yc-kang/IOTSmartHome/README.md

# IOT Smart Home Project
 
## System Architecture
This is a ESP8266-based system, with smart home control capabilities  

Check out our [presentation](Presentation.pdf) and [report](Report.pdf)

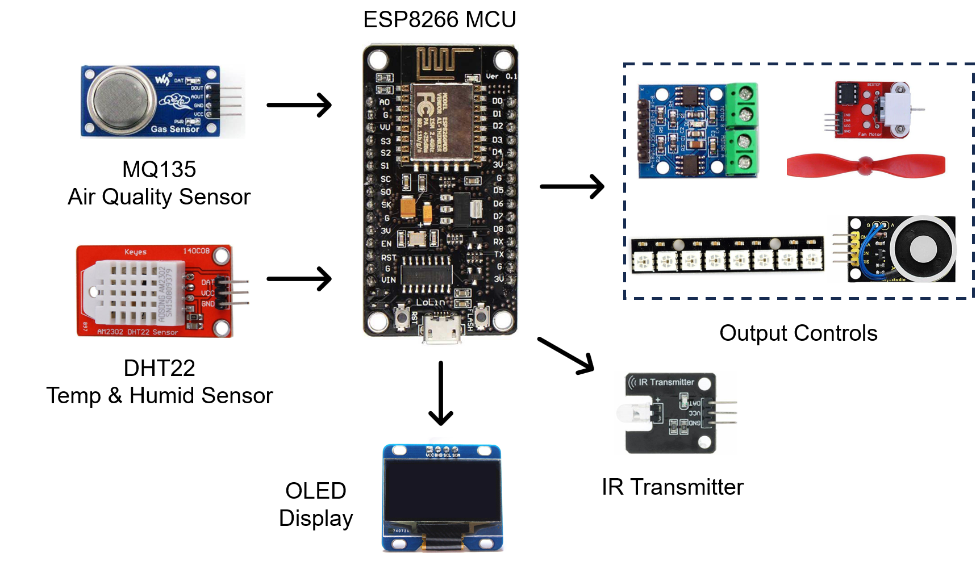
[picture p1: images/Diagram.png]

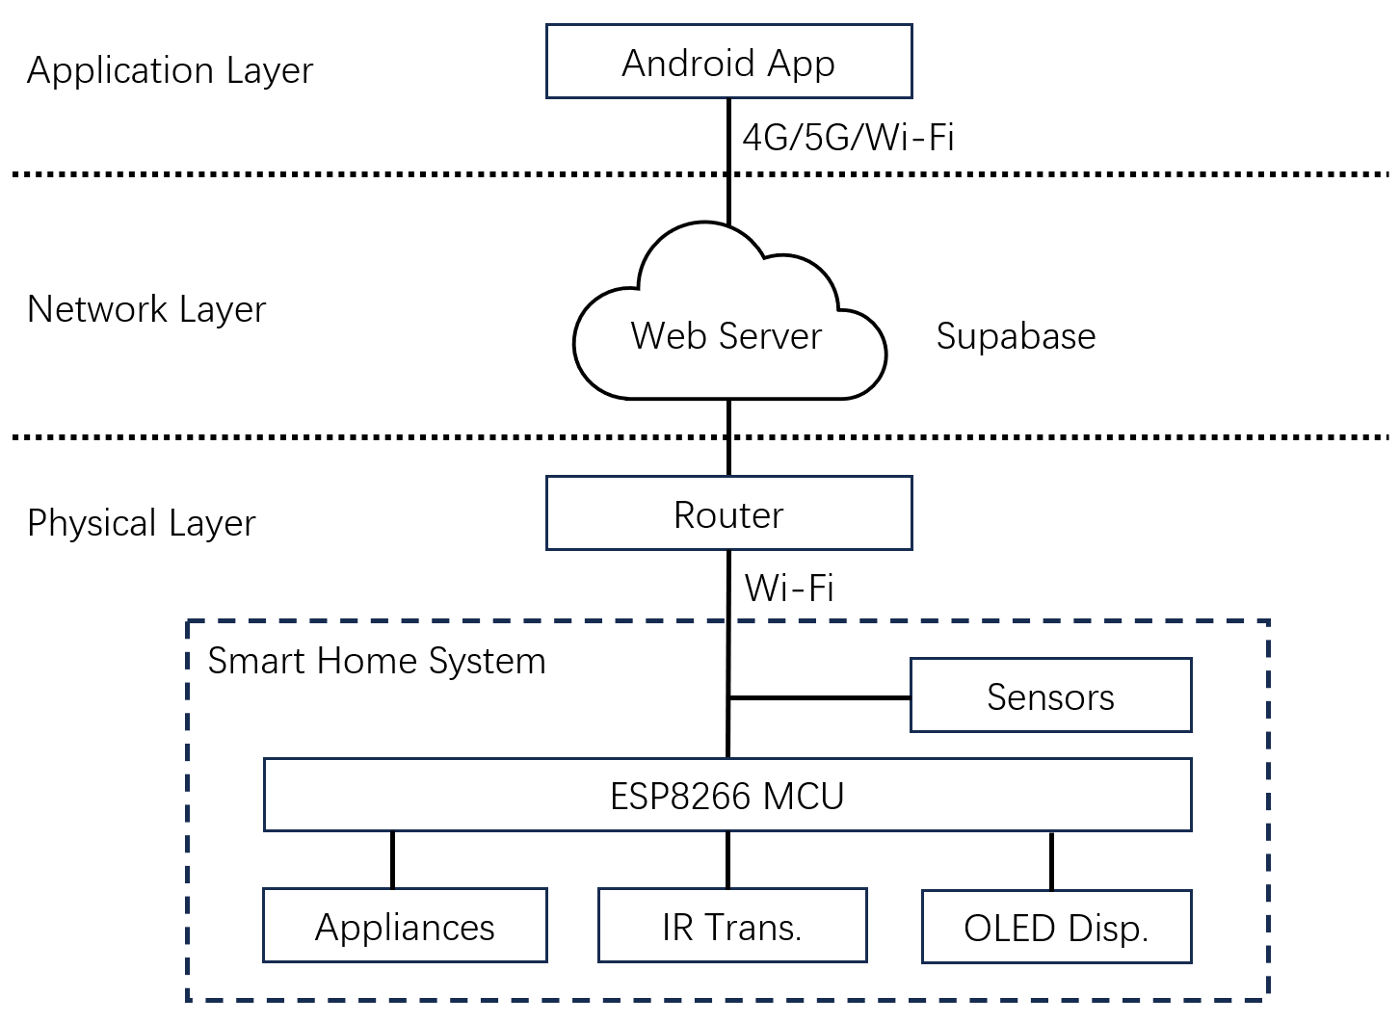
[picture p2: images/Diagram2.png]


## Circuits & PCB
Schematics, PCBs are designed via [EasyEDA](https://pro.easyeda.com/editor), referenced on [this](https://oshwhub.com/zijunchen/esp8266-extension_copy_copy_copy_copy_copy_copy_copy_copy)

The design can be access [here](Altium_NewProject_Schematic_PCB.zip), which can be imported into EasyEDA or Atrium Designer (AD)  
**Note**: Schematic, PCB, BOM List are included

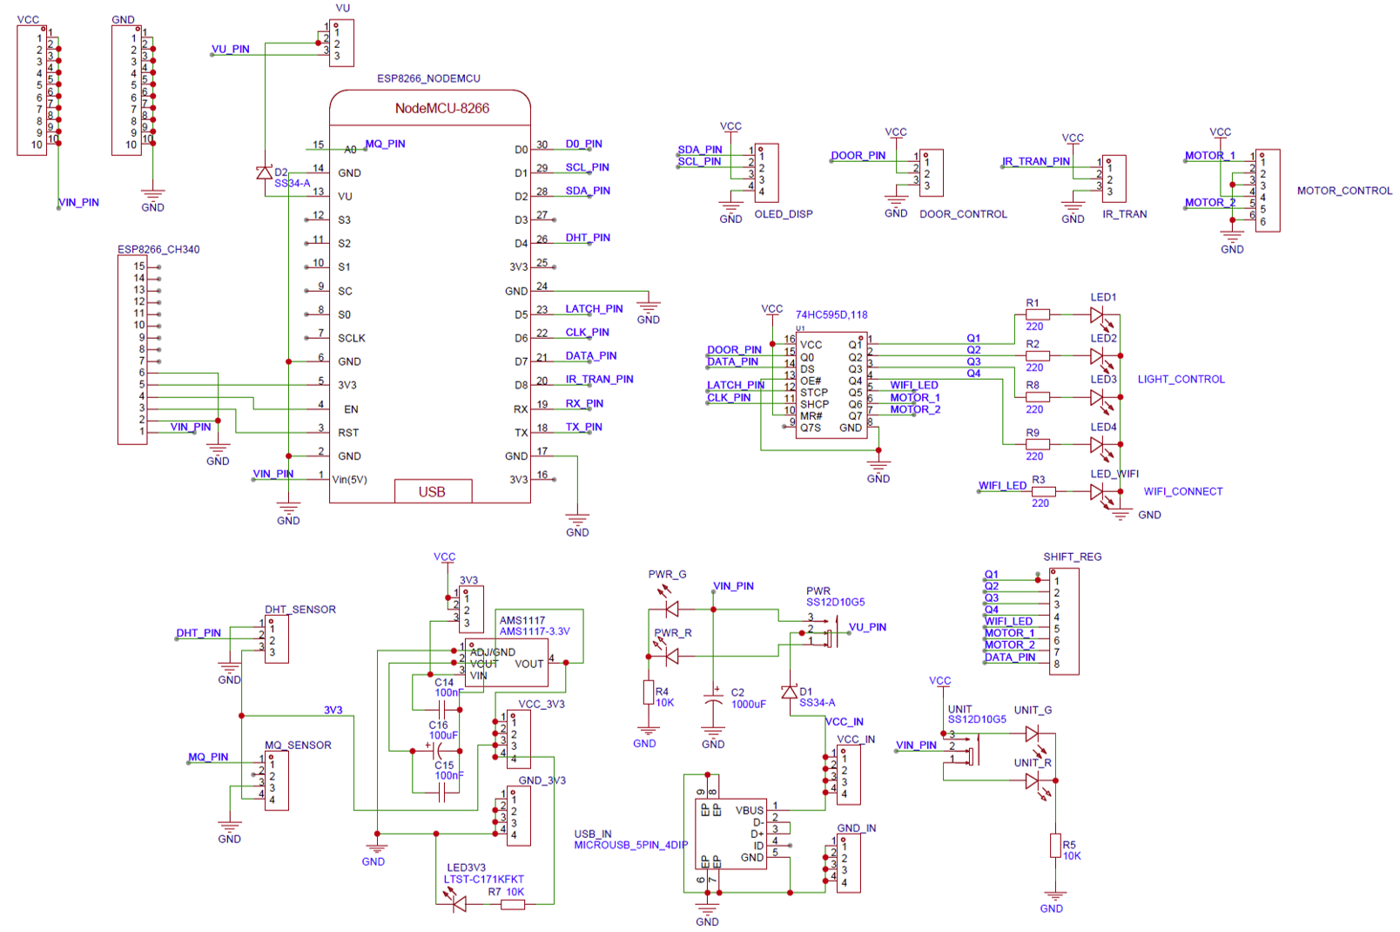
[picture p3: images/Schematic.png]


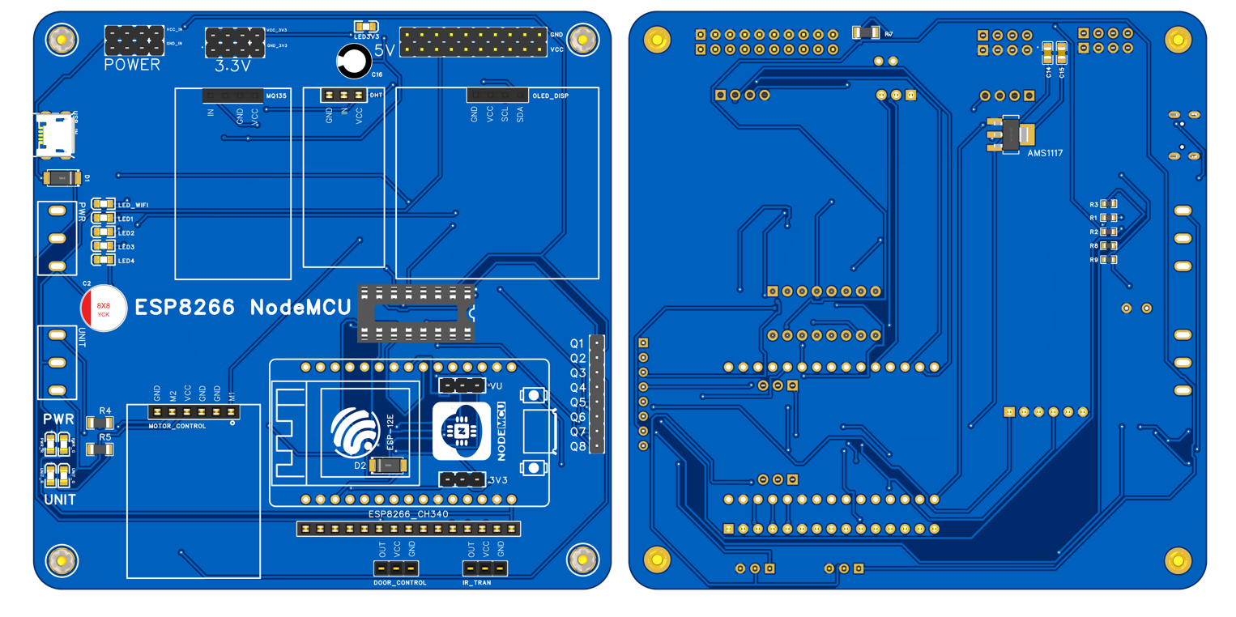
[picture p4: images/PCB.png]


Prototype
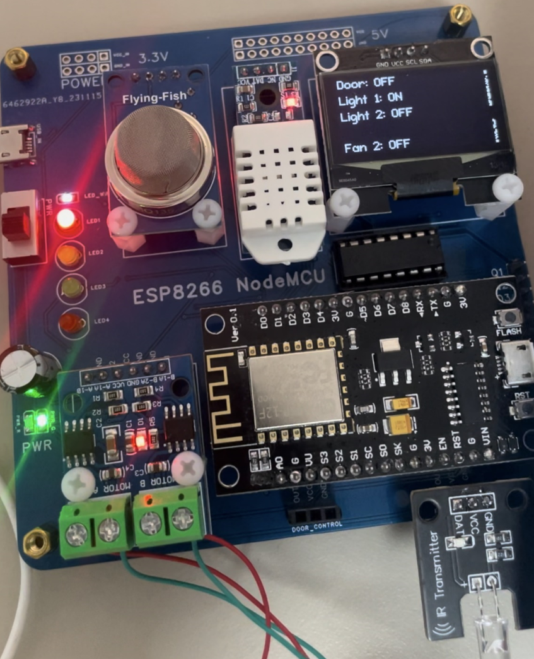
[picture p5: images/Prototype.png]


Demo
<div style="vertical-align:middle">Dataset
</div>

## Code Layout
The code is organized as follows:
- ESP8266/Main/ - Main code (ESP8266, in C)
- ESP8266/ManualTest/ - Testing (ESP8266, in C)
- AndroidApp - Flutter (in Dart)

## Android App
Designed via [FlutterFlow](https://www.flutterflow.io/), the app can be access [here](https://app.flutterflow.io/project/hotel-app-eamssf)  
*Currently in beta, not optimized for TabletView, WebApp yet
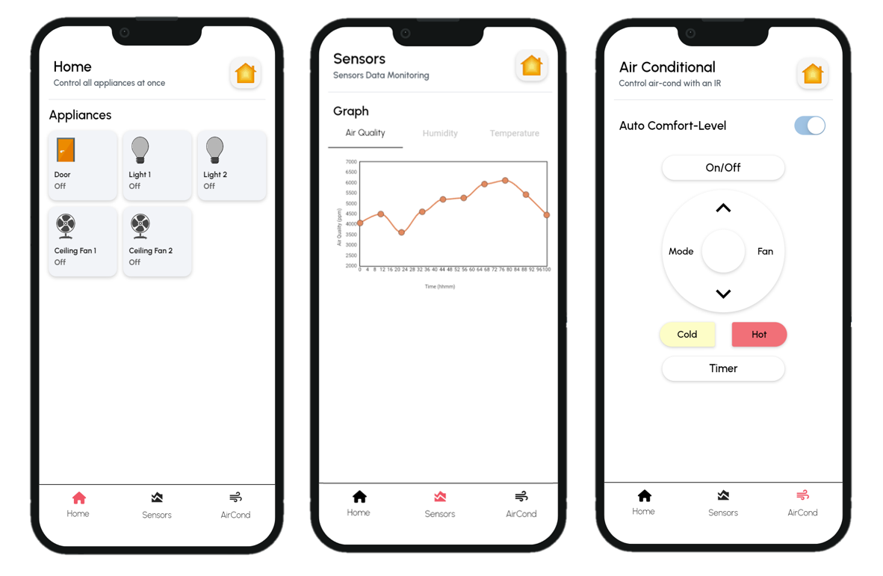
[picture p6: images/AppDesign.png]


It is **recommended** to edit in FlutterFlow directly, as oppose to import into Flutter  

## Database
Currently, the database is setup on Supabase, it's recommended to switch to Firebase, for better performance
