yc-kang/IOTSmartHome/Presentation.pdf

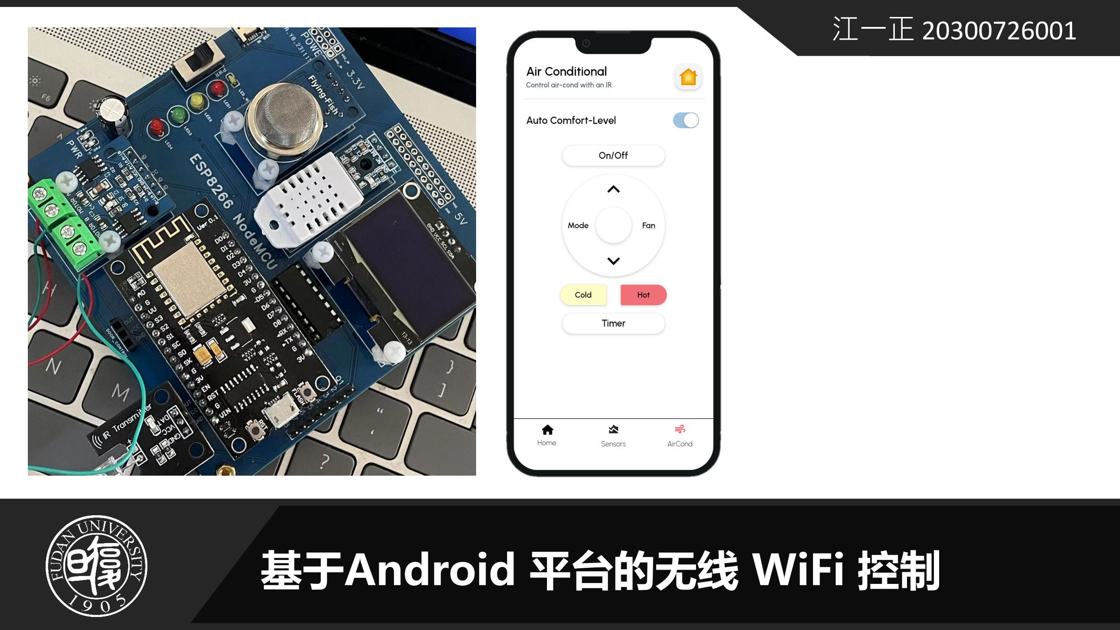
[picture p28: page 1]

# 基于Android 平台的无线 WiFi 控制

### 江一正 20300726001

ESP8266 MCU

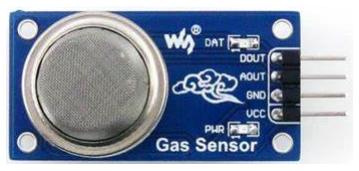
[picture p29: figure]
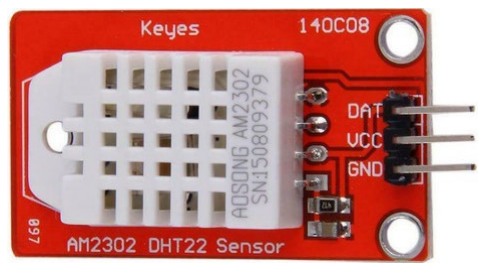
[picture p30: figure]

DHT22
Temp & Humid Sensor

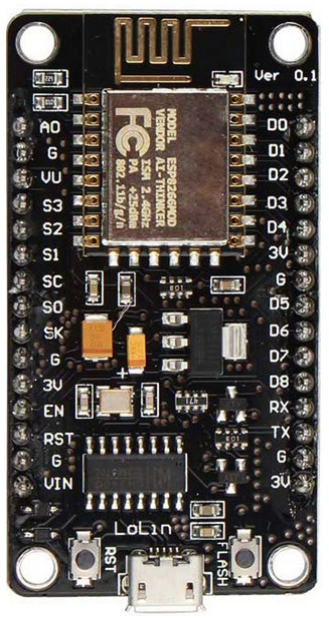
[picture p31: figure]
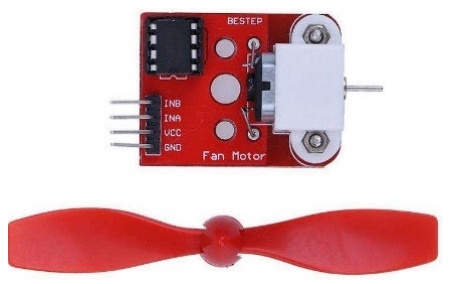
[picture p32: figure]
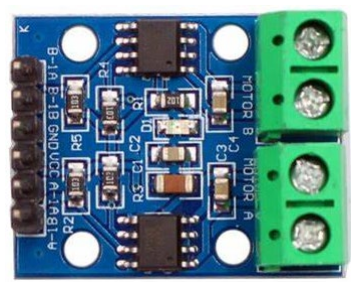
[picture p33: figure]

MQ135
Air Quality Sensor

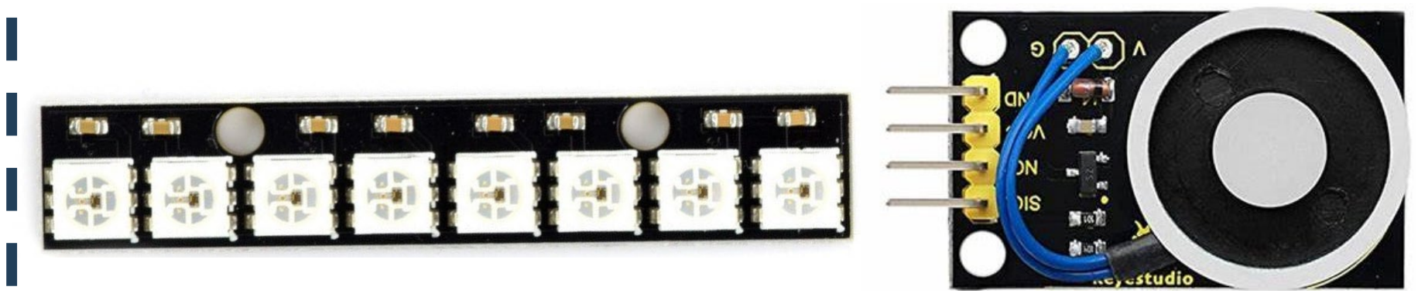
[picture p34: figure]

Output Controls

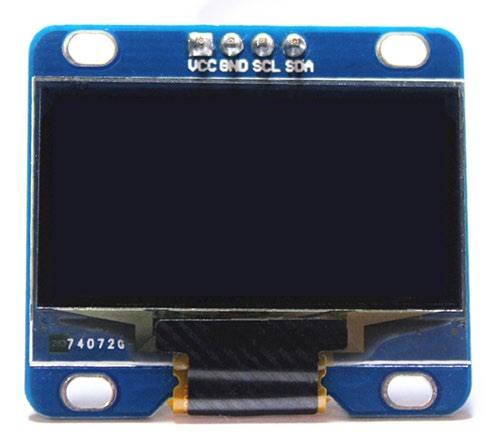
[picture p35: figure]

OLED
Display

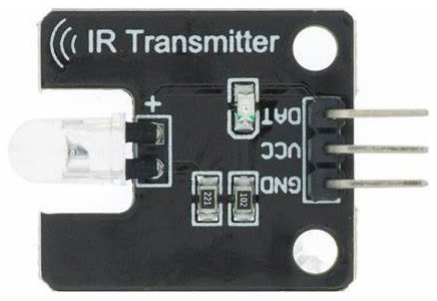
[picture p36: figure]

IR Transmitter

Application Layer

Network Layer

Physical Layer

Android App

Web Server

4G/5G/Wi-Fi

Router

Smart Home System

ESP8266 MCU

Wi-Fi

IR Trans.

Sensors

Appliances | OLED Disp.

Supabase

# 应用场景1：远程开关控制

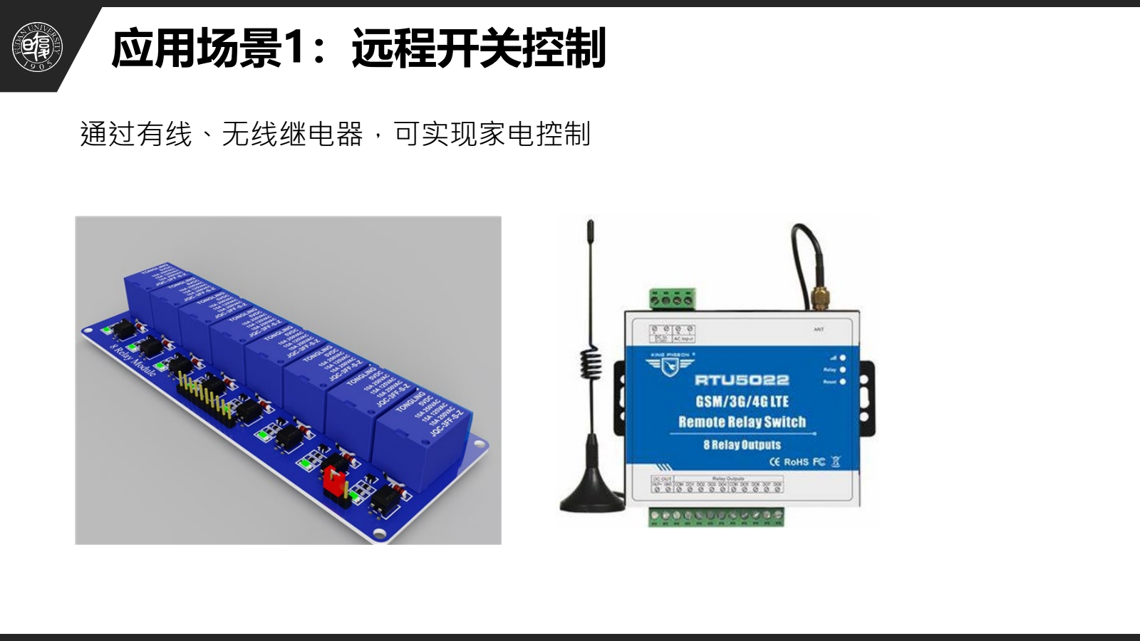
[picture p37: page 4]

通过有线、无线继电器，可实现家电控制

# 应用场景1：远程开关控制

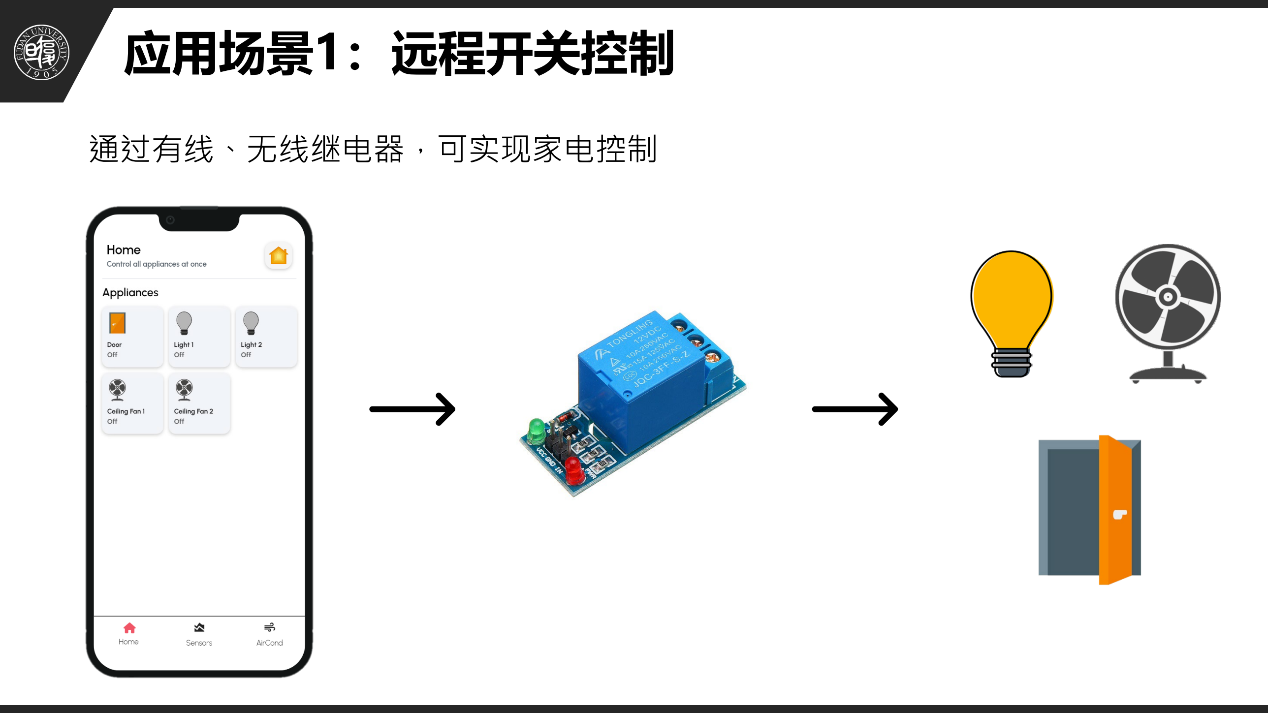
[picture p38: page 5]

通过有线、无线继电器，可实现家电控制

# 应用场景2：空调智能控制

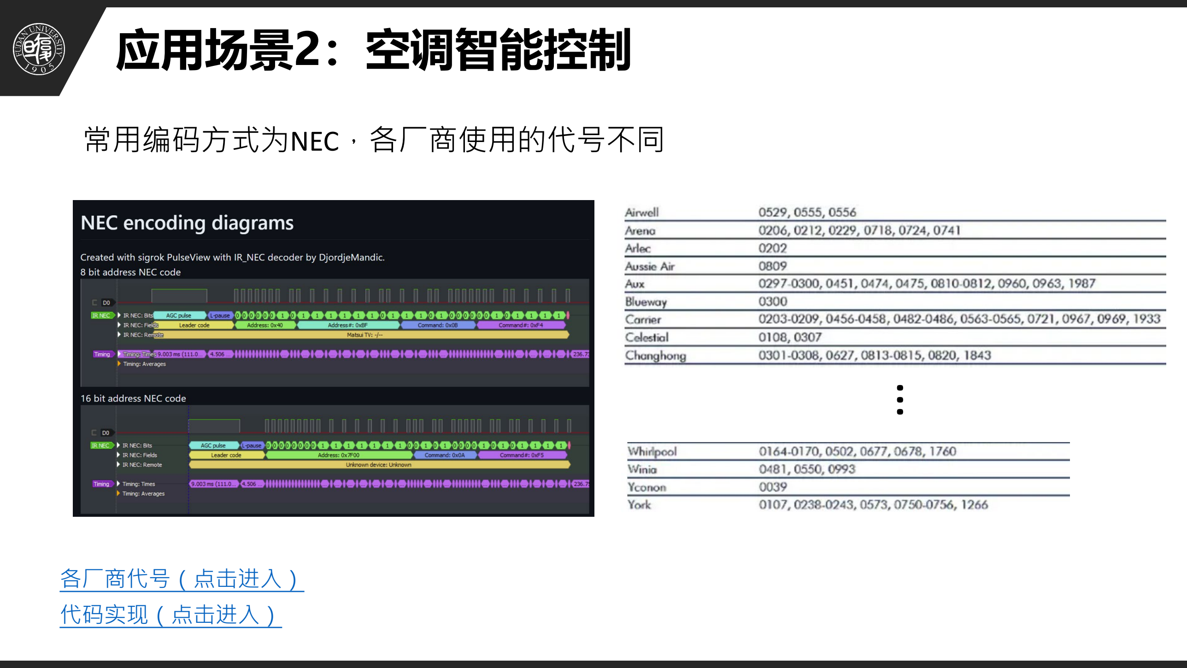
[picture p39: page 6]

常用编码方式为NEC，各厂商使用的代号不同

代码实现（点击进入） (https://github.com/Arduino-IRremote/Arduino-IRremote)

各厂商代号（点击进入） (https://removeandreplace.com/2016/06/17/universal-air-conditioner-remote-control-codes/)

…

# 应用场景2：空调智能控制

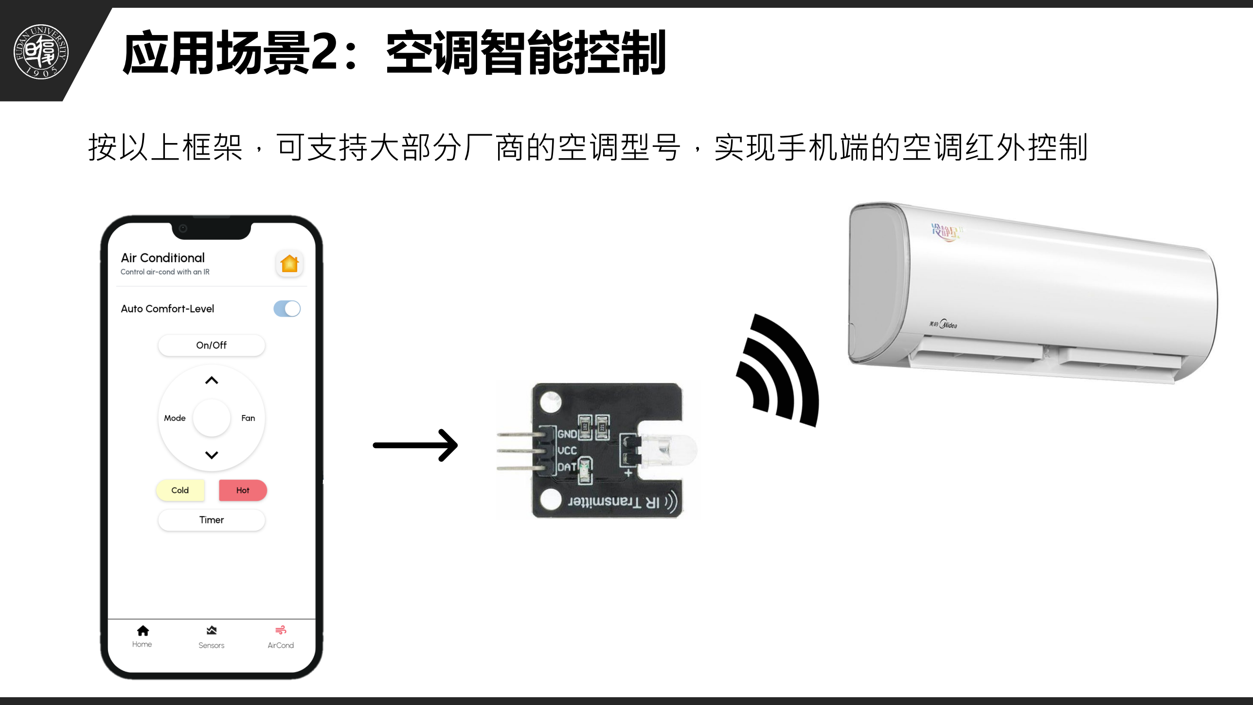
[picture p40: page 7]

按以上框架，可支持大部分厂商的空调型号，实现手机端的空调红外控制

# 应用场景3：舒适度模型

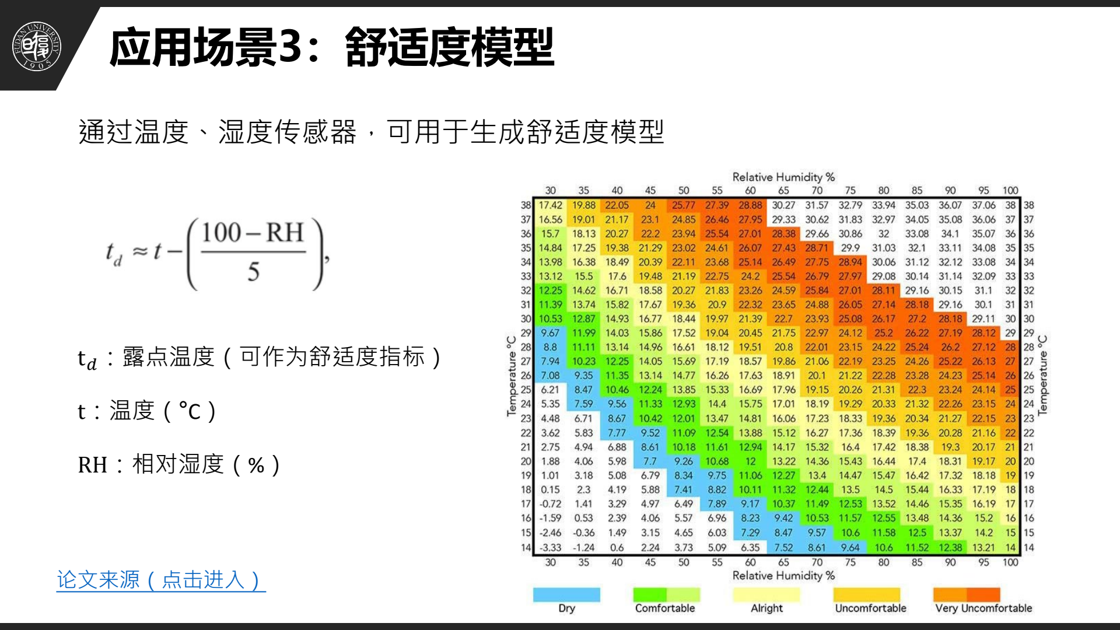
[picture p41: page 8]

通过温度、湿度传感器，可用于生成舒适度模型

tdd：露点温度（可作为舒适度指标）

t：温度（°C）

RH：相对湿度（%）

论文来源（点击进入） (https://journals.ametsoc.org/view/journals/bams/86/2/bams-86-2-225.xml?tab_body=fulltext-display)

# 应用场景3：舒适度模型

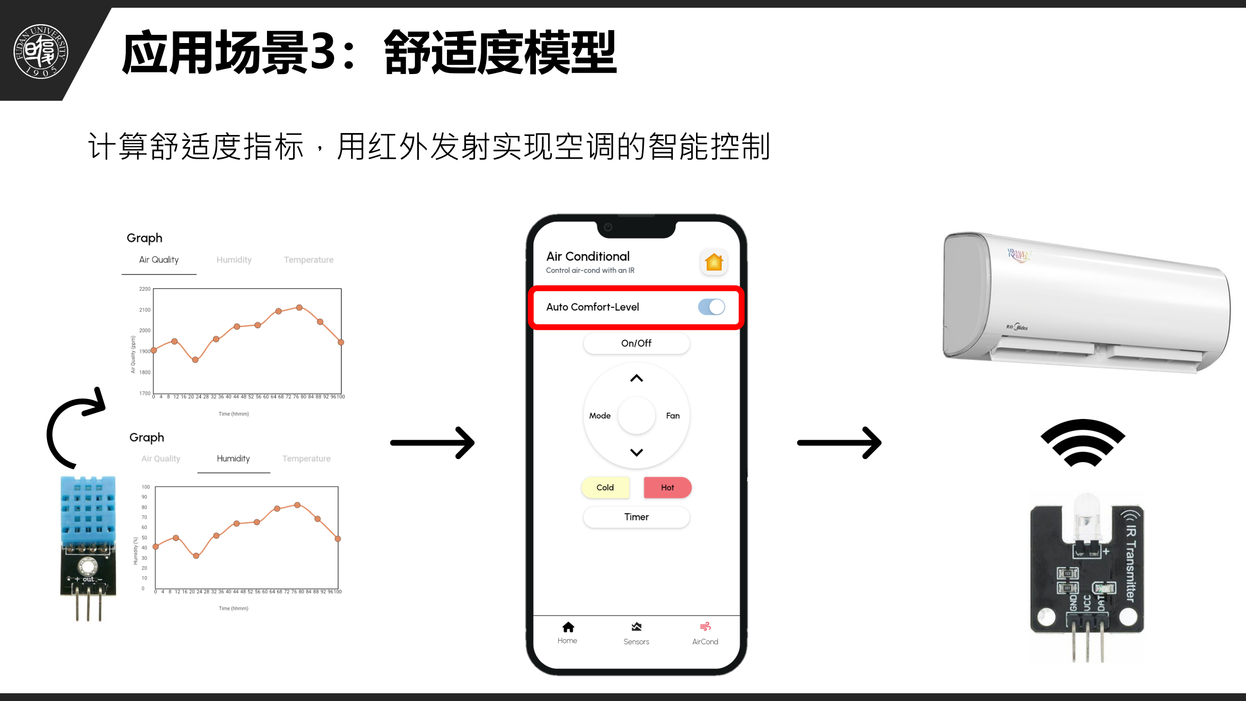
[picture p42: page 9]

计算舒适度指标，用红外发射实现空调的智能控制
