yc-kang/IOTSmartHome/AndroidApp/FlutterFlow/AndroidApp代码/assets/images/Launcher_2.png

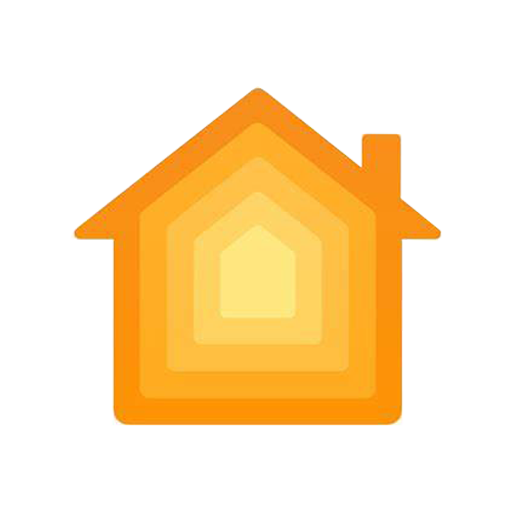
AndroidApp/FlutterFlow/AndroidApp代码/assets/images/Launcher_2.png
