yc-kang/IOTSmartHome/images/MultiDevice.jpg

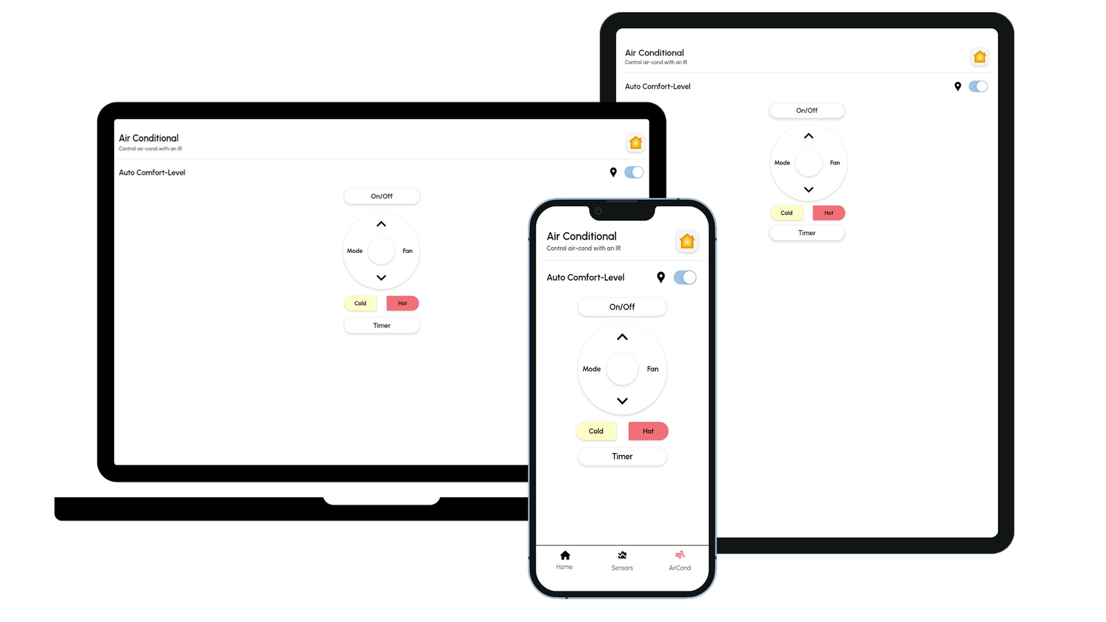
images/MultiDevice.jpg
