yc-kang/IOTSmartHome/ESP8266/ManualTest/GPIOTest/GPIOTest.ino

int led0 = 4;
int led1 = 14;
int led2 = 12;
int led3 = 13;
int led4 = 15;

void setup() {
  // put your setup code here, to run once:
  pinMode(led0, OUTPUT);
  pinMode(led1, OUTPUT);
  pinMode(led2, OUTPUT);
  pinMode(led3, OUTPUT);
  pinMode(led4, OUTPUT);

  digitalWrite(led0, 1);
  digitalWrite(led1, 1);
  digitalWrite(led2, 1);
  digitalWrite(led3, 1);
  digitalWrite(led4, 1);
}

void loop() {
  // put your main code here, to run repeatedly:

}
