yc-kang/IOTSmartHome/ESP8266/ManualTest/RealTimeClock/RealTimeClock.ino

/*
  Rui Santos
  Complete project details at https://RandomNerdTutorials.com/esp8266-nodemcu-date-time-ntp-client-server-arduino/
  
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
  The above copyright notice and this permission notice shall be included in all
  copies or substantial portions of the Software.
*/

#include <ESP8266WiFi.h>
#include <NTPClient.h>
#include <WiFiUdp.h>

// Replace with your network credentials
const char *ssid     = "";
const char *password = "";

// Define NTP Client to get time
WiFiUDP ntpUDP;
NTPClient timeClient(ntpUDP, "pool.ntp.org");

//Week Days
String weekDays[7]={"Sun", "Mon", "Tue", "Wed", "Thu", "Fri", "Sat"};
String months[12]={"Jan", "Feb", "Mar", "Apr", "May", "Jun", "Jul", "Aug", "Sep", "Oct", "Nov", "Dec"};

void setup() {
  // Initialize Serial Monitor
  Serial.begin(115200);
  
  // Connect to Wi-Fi
  Serial.print("Connecting to ");
  Serial.println(ssid);
  WiFi.begin(ssid, password);
  while (WiFi.status() != WL_CONNECTED) {
    delay(500);
    Serial.print(".");
  }

// Initialize a NTPClient to get time
  timeClient.begin();
  // Set offset time in seconds to adjust for your timezone, for example:
  // GMT +1 = 3600
  // GMT +8 = 28800
  // GMT -1 = -3600
  // GMT 0 = 0
  timeClient.setTimeOffset(28800);
}

void loop() {
  timeClient.update();

  time_t epochTime = timeClient.getEpochTime();
  Serial.print("Epoch Time: ");
  Serial.println(epochTime);
  
  String formattedTime = timeClient.getFormattedTime();
  Serial.print("Formatted Time: ");
  Serial.println(formattedTime);  

  int currentHour = timeClient.getHours();
  Serial.print("Hour: ");
  Serial.println(currentHour);  

  int currentMinute = timeClient.getMinutes();
  Serial.print("Minutes: ");
  Serial.println(currentMinute); 
   
  int currentSecond = timeClient.getSeconds();
  Serial.print("Seconds: ");
  Serial.println(currentSecond);  

  String weekDay = weekDays[timeClient.getDay()];
  Serial.print("Week Day: ");
  Serial.println(weekDay);    

  //Get a time structure
  struct tm *ptm = gmtime ((time_t *)&epochTime); 

  int monthDay = ptm->tm_mday;
  Serial.print("Month day: ");
  Serial.println(monthDay);

  int currentMonth = ptm->tm_mon+1;
  Serial.print("Month: ");
  Serial.println(currentMonth);

  String currentMonthName = months[currentMonth-1];
  Serial.print("Month name: ");
  Serial.println(currentMonthName);

  int currentYear = ptm->tm_year+1900;
  Serial.print("Year: ");
  Serial.println(currentYear);

  //Print complete date:
  String currentDate = String(currentYear) + "-" + String(currentMonth) + "-" + String(monthDay) + " (" +String(weekDays[timeClient.getDay()]) + ")";
  Serial.print("Current date: ");
  Serial.println(currentDate);

  Serial.println("");

  delay(2000);
}
